kuninet/KZ80-YM2149/README.adoc

== KZ80シリーズ用 PSG音源(YM2149/AY-3-8910)ボード

=== 概要
* SBC8080バスにつながるPSG音源(YM2149/AY-3-8910)ボードのプロジェクトです。
* 詳しい説明は以下のwikiをご覧ください。
** https://github.com/kuninet/KZ80-YM2149/wiki

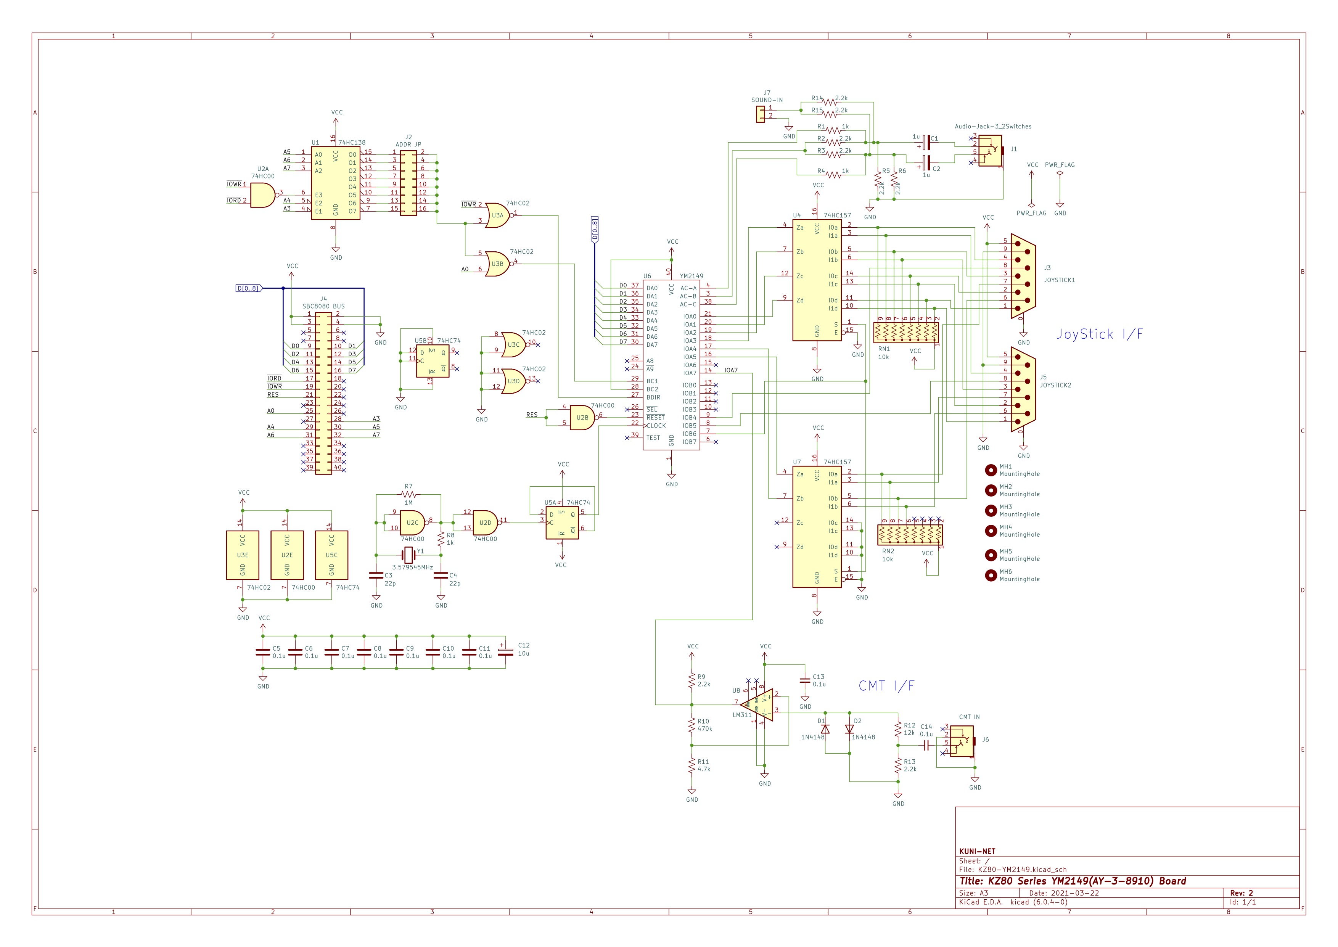
[picture p1: image/KZ80-YM2149.jpg]


=== ライセンス
* 本プロジェクトのデータはMITライセンスのもとで公開します。
