kuninet/KZ80-YM2149/joypad/README.adoc

= MSXジョイスティック サンプル

* MSX用ジョイスティックのサンプル回路です
