kuninet/KZ80-YM2149/image/KZ80-YM2149_REV1.jpg

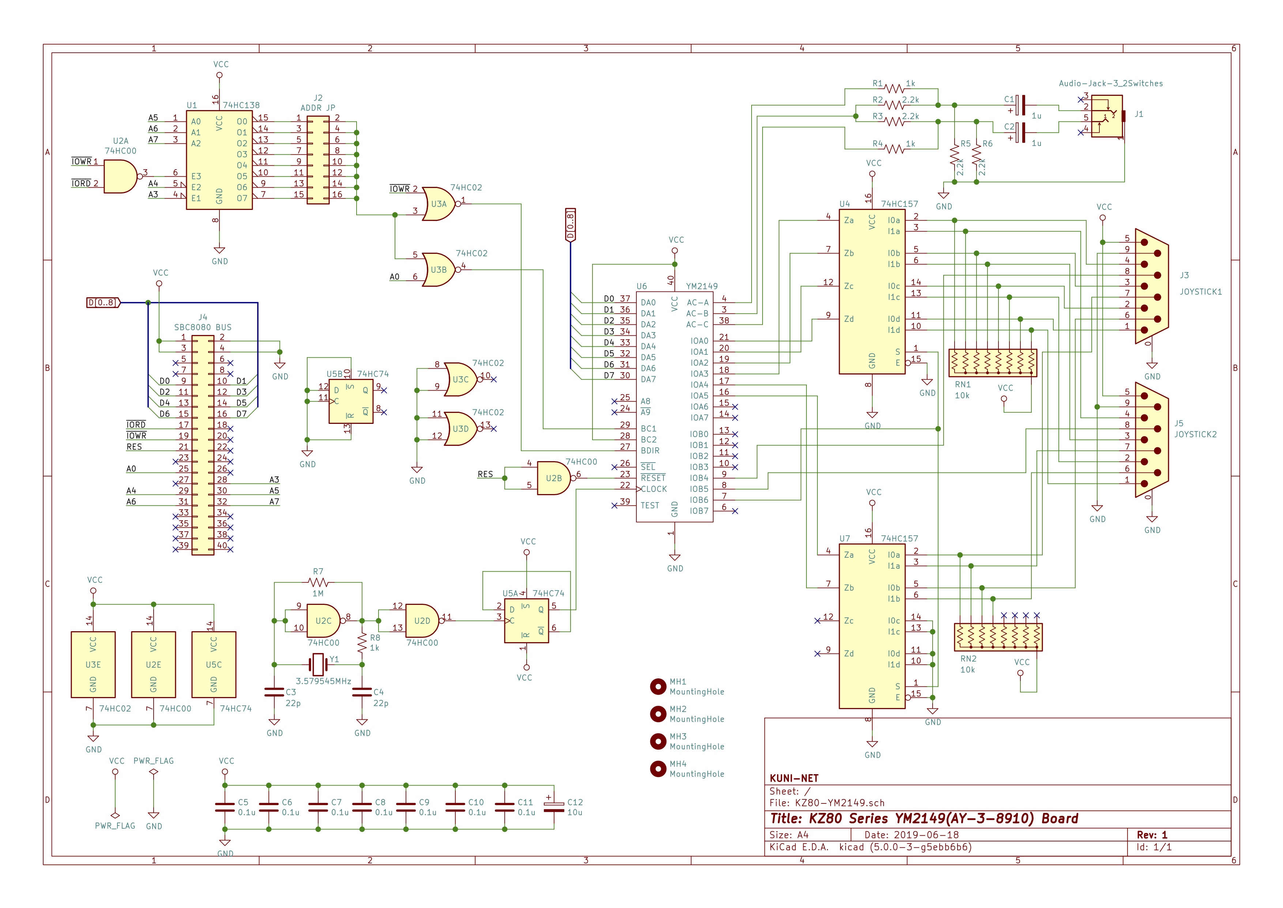
image/KZ80-YM2149_REV1.jpg
