kuninet/KZ80-YM2149/image/KZ80-YM2149.pdf

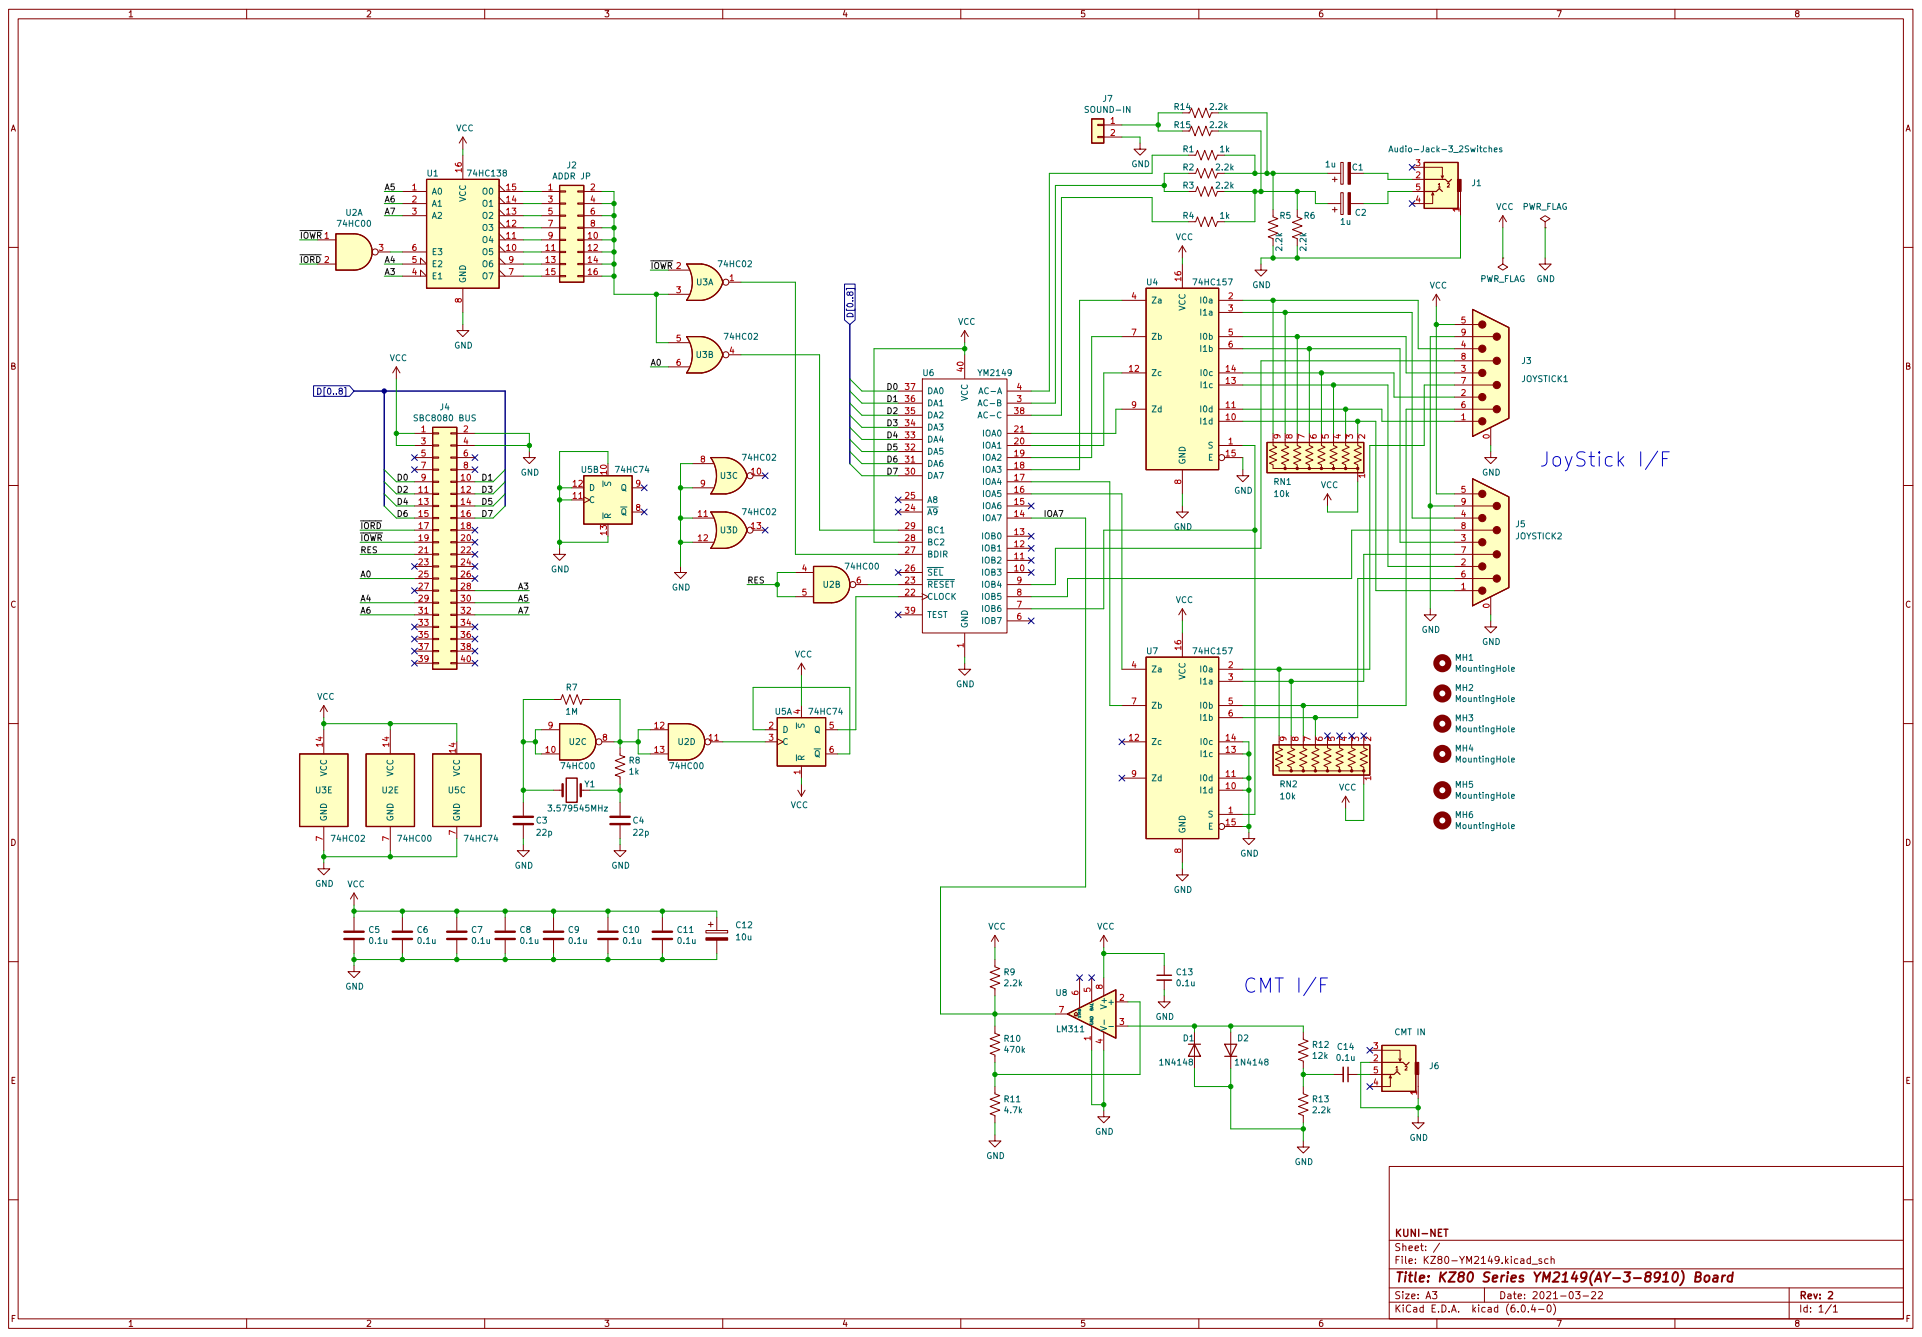
[picture p3: page 1]

11 | 12
13 | 14

Id: 1/1 Title: KZ80 Series YM2149(AY-3-8910) Board
