kuninet/KZ80-YM2149/image/KZ80-YM2149_REV1.pdf

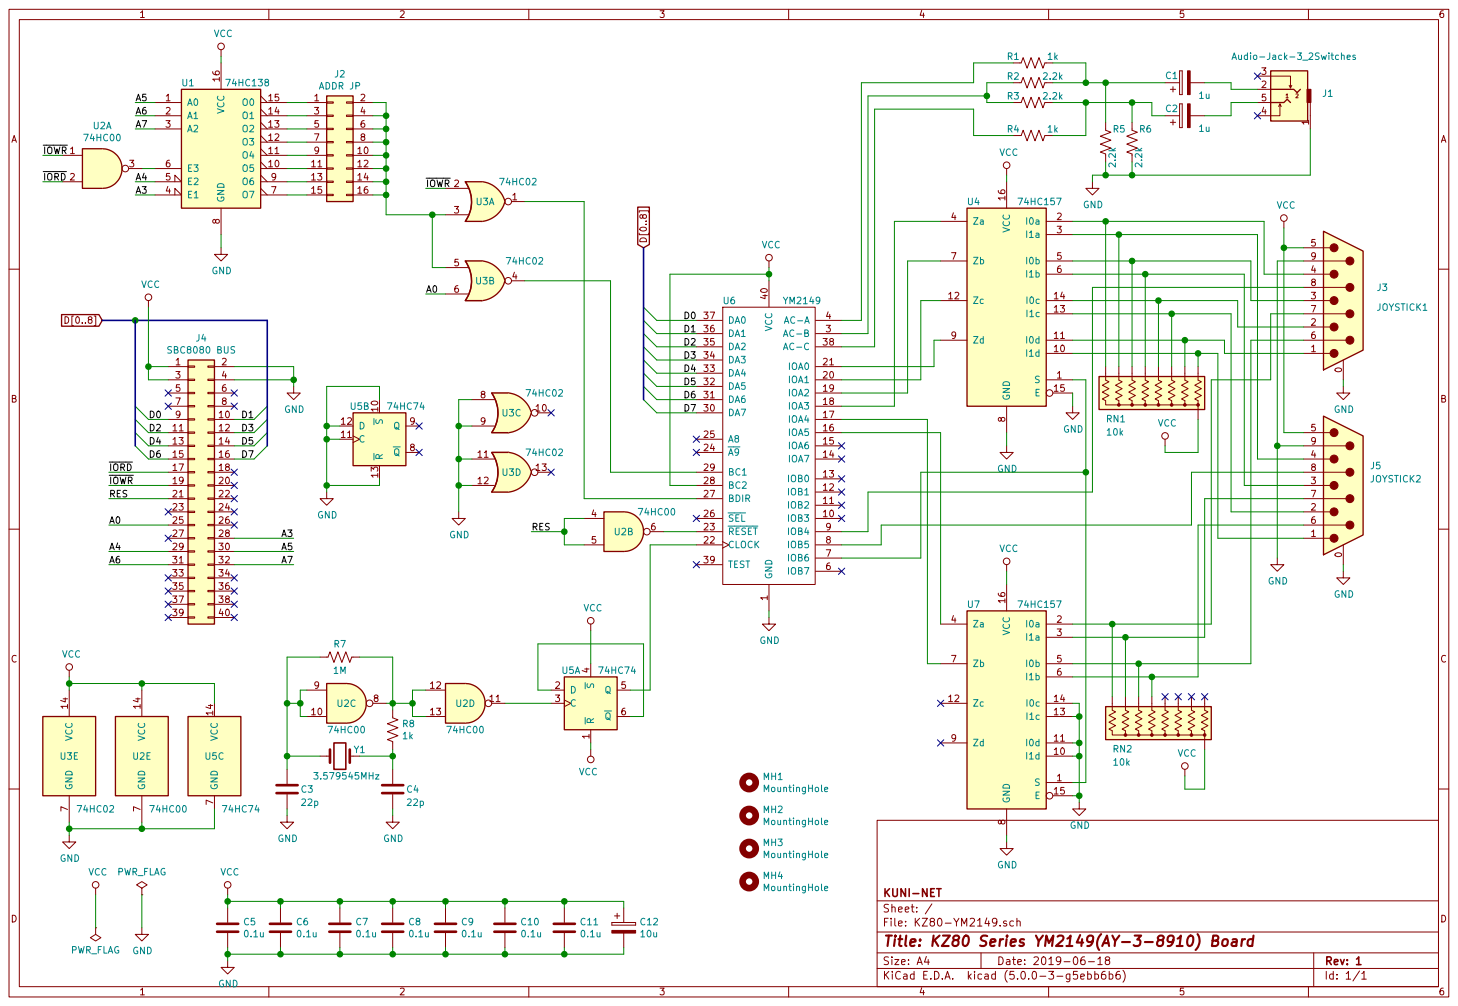
[picture p4: page 1]

9 | 10
11 | 12
13 | 14
15 | 16 | IOWR

File: KZ80-YM2149.sch Sheet: / KUNI-NET GND

Id: 1/1 Title: KZ80 Series YM2149(AY-3-8910) Board
