kuninet/KZ80-YM2149/(list of files, drawings)

Other design files:
KiCAD/KZ80-YM2149.dsn
