kuninet/KZ80-YM2149/KiCAD/KZ80-YM2149.kicad_pcb

## KiCad design KiCAD/KZ80-YM2149.kicad_pcb (2022-11-01)

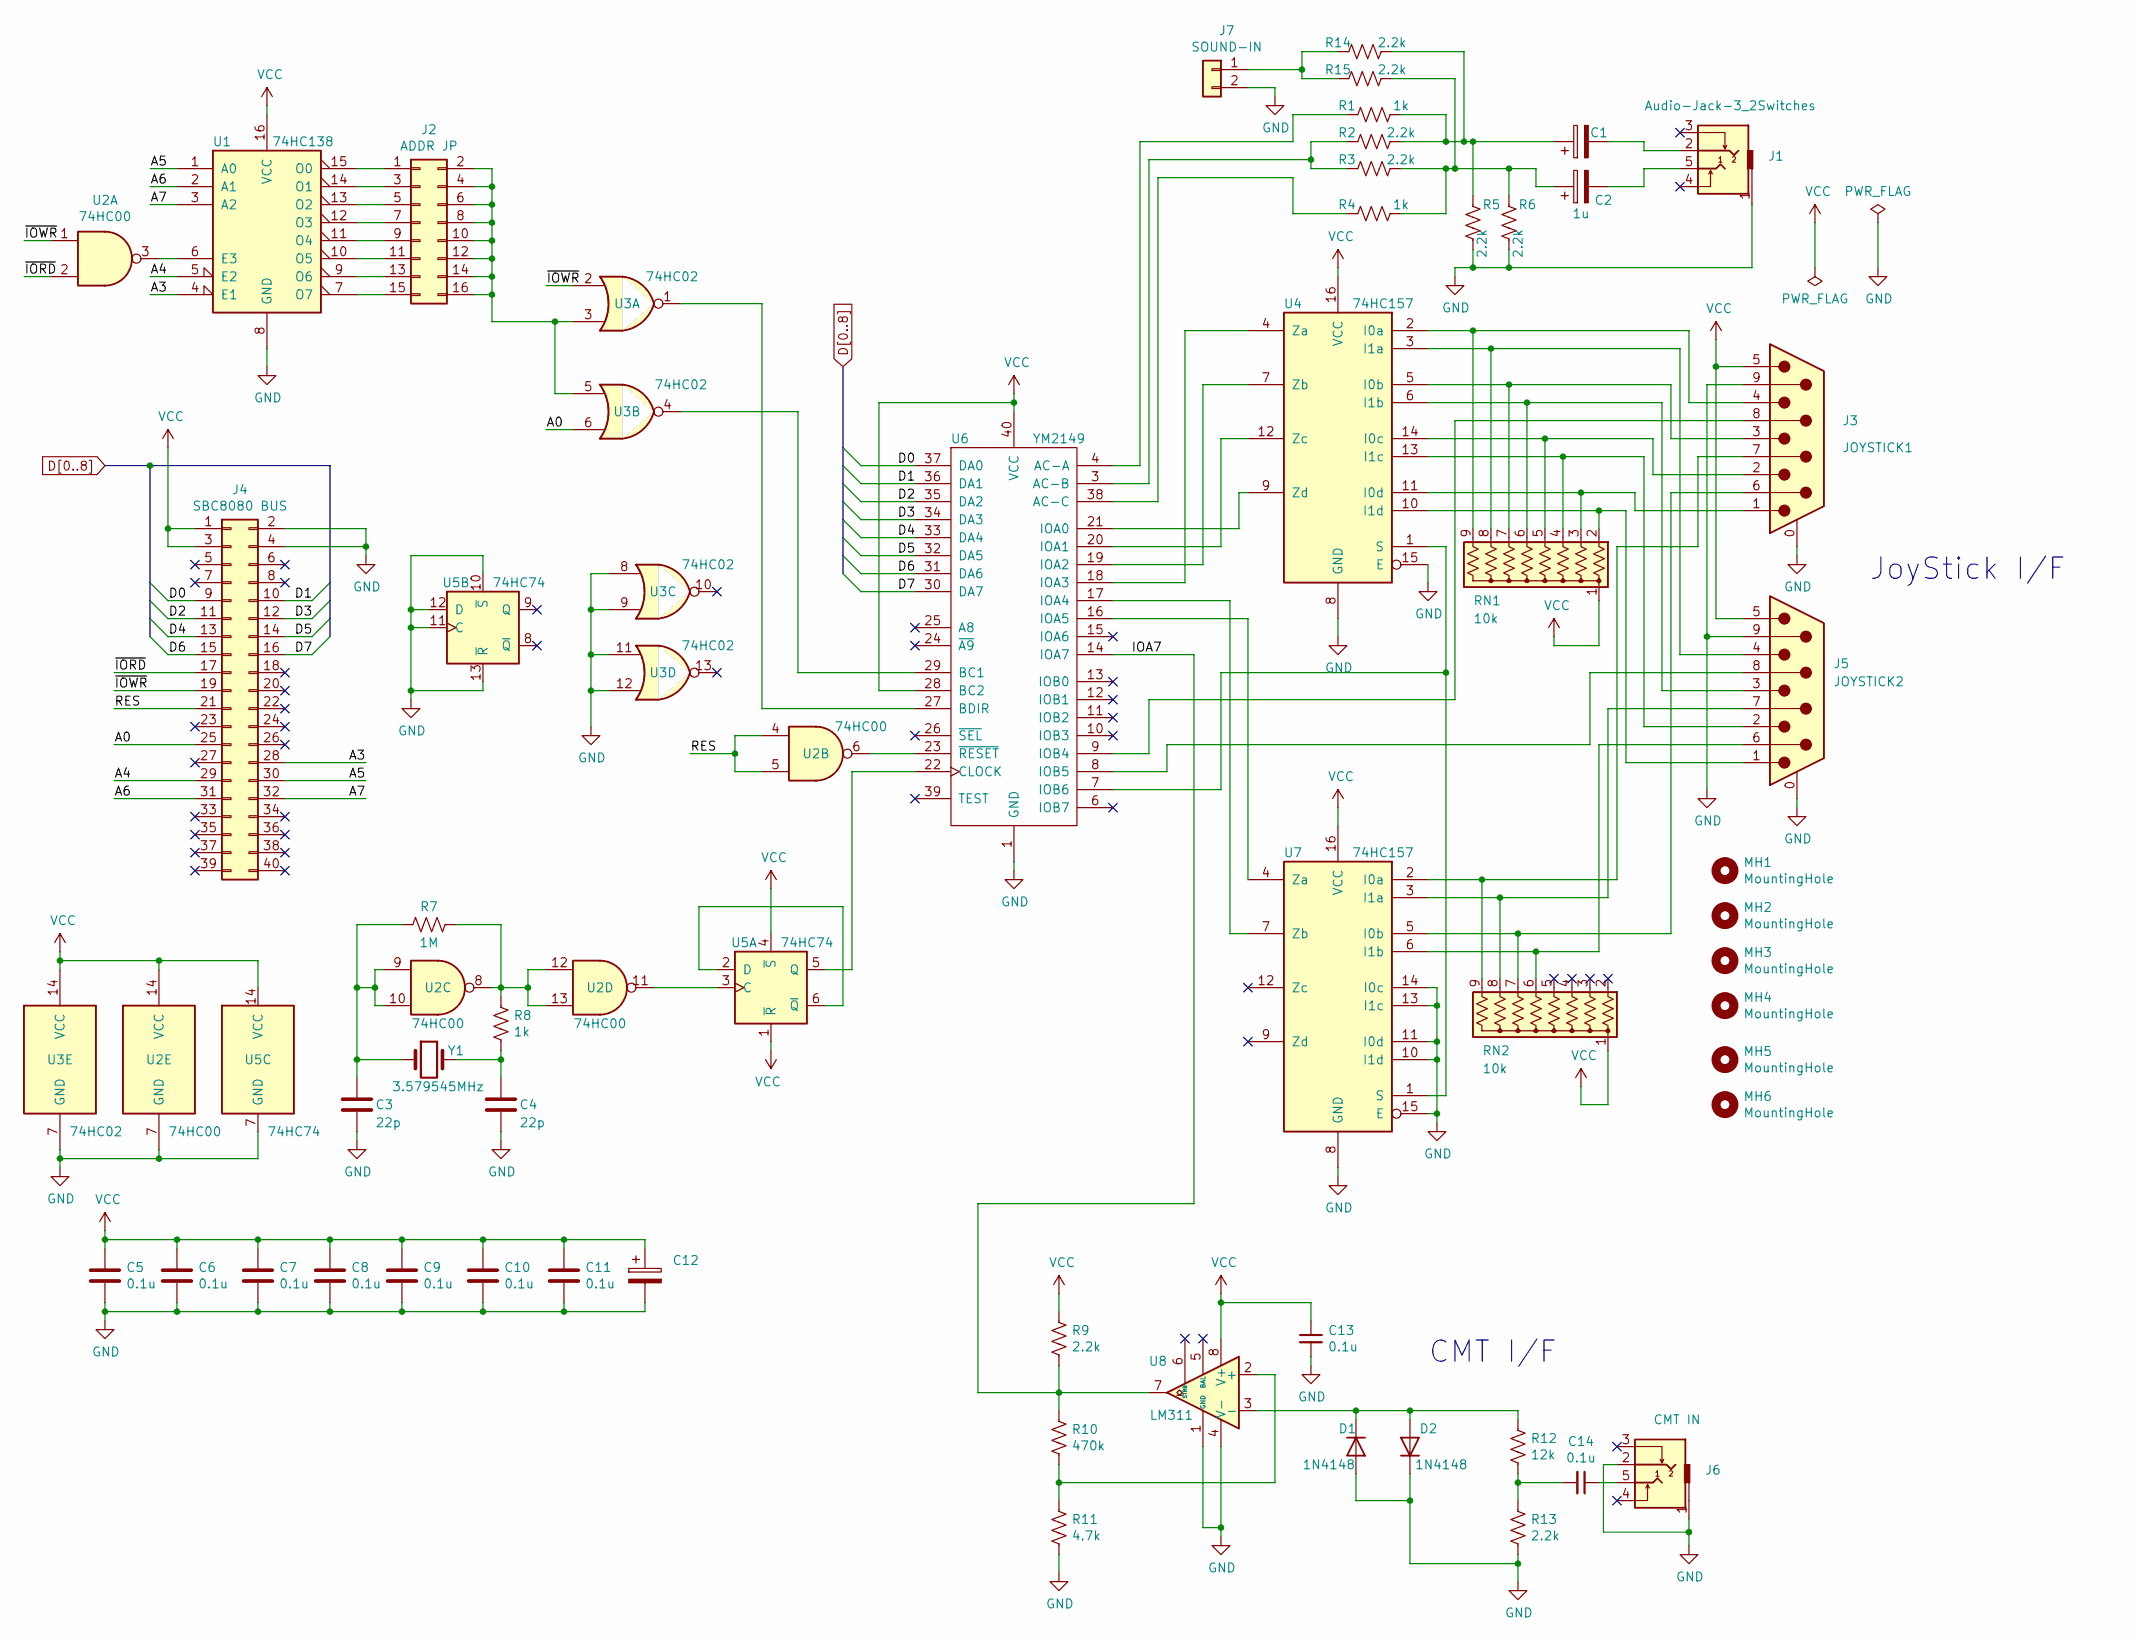
[picture p5: schematic KZ80-YM2149.kicad_sch, KZ80 Series YM2149(AY-3-8910) Board]

Parts:
C1, C12: (no value)
C2: 1u
C3, C4: 22p; C_Disc_D3.0mm_W1.6mm_P2.50mm
C5, C6, C7, C8, C9, C10, C11, C13, C14: 0.1u; C_Disc_D3.0mm_W1.6mm_P2.50mm
D1, D2: 1N4148; D_DO-35_SOD27_P7.62mm_Horizontal
J1: Audio-Jack-3_2Switches; AJ-1780
J2: ADDR JP; PinHeader_2x08_P2.54mm_Vertical
J3: JOYSTICK1; DSUB-9_Male_Horizontal_P2.77x2.54mm_EdgePinOffset9.40mm
J4: SBC8080 BUS; PinHeader_2x20_P2.54mm_Horizontal
J5: JOYSTICK2; DSUB-9_Male_Horizontal_P2.77x2.54mm_EdgePinOffset9.40mm
J6: CMT IN; AJ-1780
J7: SOUND-IN; PinHeader_1x02_P2.54mm_Vertical
MH1, MH2, MH3, MH4, MH5, MH6: MountingHole; MountingHole_3.2mm_M3
R1, R4, R8: 1k; R_Axial_DIN0207_L6.3mm_D2.5mm_P10.16mm_Horizontal
R2, R3, R5, R6, R9, R13, R14, R15: 2.2k; R_Axial_DIN0207_L6.3mm_D2.5mm_P10.16mm_Horizontal
R7: 1M; R_Axial_DIN0207_L6.3mm_D2.5mm_P10.16mm_Horizontal
R10: 470k; R_Axial_DIN0207_L6.3mm_D2.5mm_P10.16mm_Horizontal
R11: 4.7k; R_Axial_DIN0207_L6.3mm_D2.5mm_P10.16mm_Horizontal
R12: 12k; R_Axial_DIN0207_L6.3mm_D2.5mm_P10.16mm_Horizontal
RN1, RN2: 10k; R_Array_SIP9
U1: 74HC138; DIP-16_W7.62mm_Socket
U2: 74HC00; DIP-14_W7.62mm_Socket
U3: 74HC02; DIP-14_W7.62mm_Socket
U4, U7: 74HC157; DIP-16_W7.62mm_Socket
U5: 74HC74; DIP-14_W7.62mm_Socket
U6: YM2149; DIP-40_W15.24mm_Socket
U8: LM311; DIP-8_W7.62mm_Socket_LongPads
Y1: 3.579545MHz; Crystal_HC49-U_Vertical

Connections:
/A0: J4.25, U3.6
/A3: J4.28, U1.4 (E1)
/A4: J4.29, U1.5 (E2)
/A5: J4.30, U1.1 (A0)
/A6: J4.31, U1.2 (A1)
/A7: J4.32, U1.3 (A2)
/IOA7: R9.2, R10.1, U6.14 (IOA7), U8.7
/RES: J4.21, U2.4, U2.5
/~IORD: J4.17, U2.2
/~IOWR: J4.19, U2.1, U3.2
D0: J4.9, U6.37 (DA0)
D1: J4.10, U6.36 (DA1)
D2: J4.11, U6.35 (DA2)
D3: J4.12, U6.34 (DA3)
D4: J4.13, U6.33 (DA4)
D5: J4.14, U6.32 (DA5)
D6: J4.15, U6.31 (DA6)
D7: J4.16, U6.30 (DA7)
GND: C3.2, C4.2, C5.2, C6.2, C7.2, C8.2, C9.2, C10.2, C11.2, C12.2, C13.2, D1.2 (A), D2.1 (K), J1.1, J3.0 (PAD), J3.9, J4.2, J4.4, J5.0 (PAD), J5.9, J6.1, J6.2, J7.2, R5.2, R6.2, R11.2, R13.2, U1.8 (GND), U2.7 (GND), U3.7 (GND), U3.8, U3.9, U3.11, U3.12, U4.8 (GND), U4.15 (E), U5.7 (GND), U5.10 (~S), U5.11 (C), U5.12 (D), U5.13 (~R), U6.1 (GND), U7.8 (GND), U7.10 (I1d), U7.11 (I0d), U7.13 (I1c), U7.14 (I0c), U7.15 (E), U8.1 (GND), U8.4 (V-)
unnamed: C3.1, R7.2, U2.9, U2.10, Y1.1
unnamed: C4.1, R8.2, Y1.2
unnamed: C14.1, J6.5
unnamed: C14.2, R12.2, R13.1
unnamed: D1.1 (K), D2.2 (A), R12.1, U8.3 (-)
unnamed: C1.2, J1.2
unnamed: C2.2, J1.5
unnamed: J2.1, U1.15 (O0)
unnamed: J2.3, U1.14 (O1)
unnamed: J2.5, U1.13 (O2)
unnamed: J2.7, U1.12 (O3)
unnamed: J2.9, U1.11 (O4)
unnamed: J2.2, J2.4, J2.6, J2.8, J2.10, J2.12, J2.14, J2.16, U3.3, U3.5
unnamed: J2.11, U1.10 (O5)
unnamed: J2.13, U1.9 (O6)
unnamed: J2.15, U1.7 (O7)
unnamed: J3.1, RN1.3 (R2), U4.11 (I0d)
unnamed: J3.2, RN1.5 (R4), U4.14 (I0c)
unnamed: J3.3, RN1.7 (R6), U4.5 (I0b)
unnamed: J3.4, RN1.9 (R8), U4.2 (I0a)
unnamed: J3.6, RN2.7 (R6), U7.5 (I0b)
unnamed: J3.7, RN2.9 (R8), U7.2 (I0a)
unnamed: J3.8, U6.9 (IOB4)
unnamed: J5.1, RN1.2 (R1), U4.10 (I1d)
unnamed: J5.2, RN1.4 (R3), U4.13 (I1c)
unnamed: J5.3, RN1.6 (R5), U4.6 (I1b)
unnamed: J5.4, RN1.8 (R7), U4.3 (I1a)
unnamed: J5.6, RN2.6 (R5), U7.6 (I1b)
unnamed: J5.7, RN2.8 (R7), U7.3 (I1a)
unnamed: J5.8, U6.8 (IOB5)
unnamed: J7.1, R14.2, R15.2
unnamed: C1.1, R1.1, R2.1, R5.1, R14.1
unnamed: R1.2, U6.4 (AC-A)
unnamed: R2.2, R3.2, U6.3 (AC-B)
unnamed: R4.2, U6.38 (AC-C)
unnamed: R7.1, R8.1, U2.8, U2.12, U2.13
unnamed: R10.2, R11.1, U8.2 (+)
unnamed: C2.1, R3.1, R4.1, R6.1, R15.1
unnamed: U1.6 (E3), U2.3
unnamed: U2.6, U6.23 (~RESET)
unnamed: U2.11, U5.3 (C)
unnamed: U3.1, U6.27 (BDIR)
unnamed: U3.4, U6.29 (BC1)
unnamed: U4.1 (S), U6.7 (IOB6), U7.1 (S)
unnamed: U4.4 (Za), U6.18 (IOA3)
unnamed: U4.7 (Zb), U6.19 (IOA2)
unnamed: U4.9 (Zd), U6.21 (IOA0)
unnamed: U4.12 (Zc), U6.20 (IOA1)
unnamed: U5.2 (D), U5.6 (~Q)
unnamed: U5.5 (Q), U6.22 (CLOCK)
unnamed: U6.16 (IOA5), U7.4 (Za)
unnamed: U6.17 (IOA4), U7.7 (Zb)
VCC: C5.1, C6.1, C7.1, C8.1, C9.1, C10.1, C11.1, C12.1, C13.1, J3.5, J4.1, J4.3, J5.5, R9.1, RN1.1 (common), RN2.1 (common), U1.16 (VCC), U2.14 (VCC), U3.14 (VCC), U4.16 (VCC), U5.1 (~R), U5.4 (~S), U5.14 (VCC), U6.28 (BC2), U6.40 (VCC), U7.16 (VCC), U8.8 (V+)

Notes on the sheet:
JoyStick I/F
CMT I/F

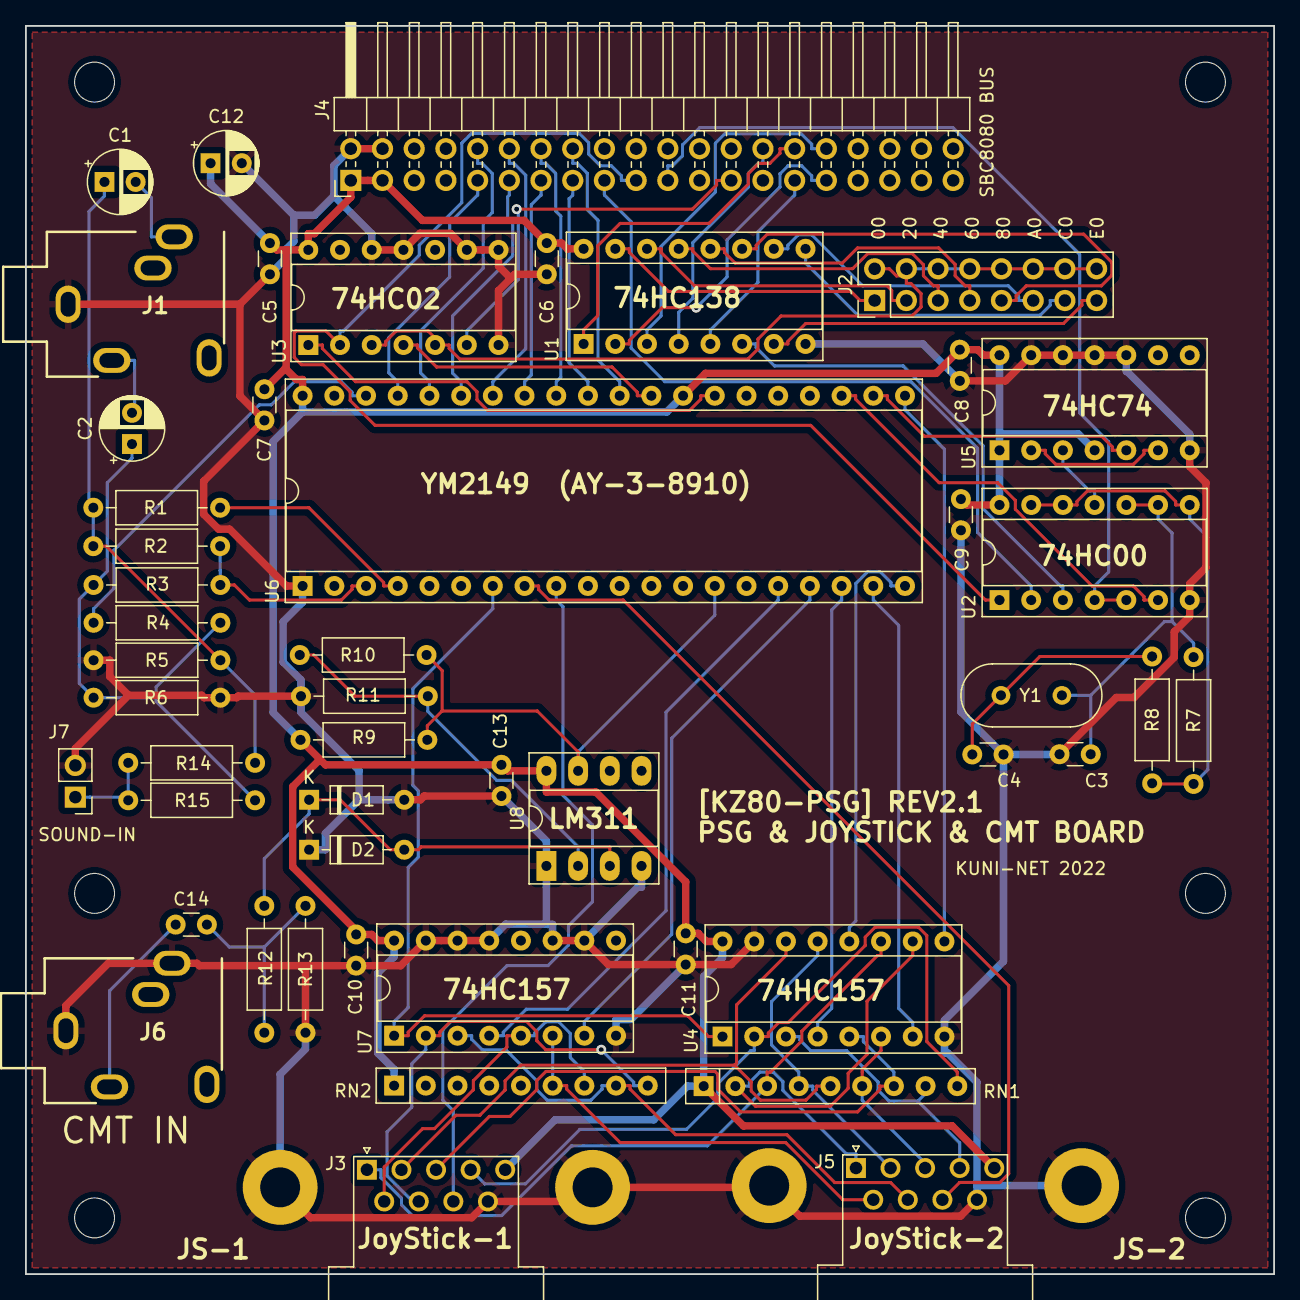
[picture p6: board KZ80-YM2149.kicad_pcb from above]

Board: 2 copper layers, 100.0 x 100.0 mm, 55 parts (0 on the bottom side), 72 nets.
