kuninet/KZ80-YM2149/(commit log)

2019-07-16 init commit
    [KZ80-YM2149.dsn, KZ80-YM2149.kicad_pcb, KZ80-YM2149.sch]
2019-07-16 README更新 & 回路図イメージ添付
2019-08-10 ジョイスティックポート接続&プリントパターン見直し
    [KZ80-YM2149.GBL, KZ80-YM2149.GBO, KZ80-YM2149.GBP, KZ80-YM2149.GBS, KZ80-YM2149.GKO, KZ80-YM2149.GTL, KZ80-YM2149.GTO, KZ80-YM2149.GTP]
2019-08-10 パターン間違い修正&ガーバーデータ再出力
    [KZ80-YM2149.GBL, KZ80-YM2149.GBO, KZ80-YM2149.GBP, KZ80-YM2149.GBS, KZ80-YM2149.GKO, KZ80-YM2149.GTL, KZ80-YM2149.GTO, KZ80-YM2149.GTP]
2019-08-11 演奏プログラムサンプル追加
2019-08-11 演奏プログラム 曲データアドレス変更→$9000
2019-08-17 ジョイスティックテストCプログラム作成
2019-09-02 回路図 クロック等 微修正
    [KZ80-YM2149.csv, KZ80-YM2149.sch]
2019-09-07 ガーバーデータ出力項目見直し。ガーバーデータ再出力
    [KZ80-YM2149.GBL, KZ80-YM2149.GBO, KZ80-YM2149.GBP, KZ80-YM2149.GBS, KZ80-YM2149.GKO, KZ80-YM2149.GTL, KZ80-YM2149.GTO, KZ80-YM2149.GTP]
2019-09-07 ガーバーデータ出力項目見直し分、追加コミット
    [KZ80-YM2149.kicad_pcb]
2019-09-07 ジョイスティック シルク追加
    [KZ80-YM2149.kicad_pcb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]
2021-03-22 REV2基板 回路回路、パターン作成・ガーバー出力
    [KZ80-YM2149.dsn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]
2021-03-22 REV1回路図分離
2021-03-22 回路図間違い修正・ガーバー再出力
    [KZ80-YM2149.kicad_pcb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]
2021-03-22 回路図差し替え
2022-06-07 KiCAD6対応 & CMTステレオジャック回路修正 ・ガーバー2.1出力 #2
    [KZ80-YM2149.dsn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]
2022-06-07 コンデンサシンボル変更忘れ対応 #2
    [KZ80-YM2149.dsn, KZ80-YM2149.kicad_pcb, KZ80-YM2149.kicad_sch]
2022-06-07 回路図イメージ差し替え
2022-11-01 REV2.1ガーバーデータ再作成
    [KZ80-YM2149.GBL, KZ80-YM2149.GBO, KZ80-YM2149.GBP, KZ80-YM2149.GBS, KZ80-YM2149.GTL, KZ80-YM2149.GTO, KZ80-YM2149.GTP, KZ80-YM2149.GTS]
